eden-miz/R6P4/Rapport seances/Mizrahi_Rapport scéance 8.docx

Rapport scéance 8

A la dernière scéance j’avais essayé de souder les éléments à une plaque plus fine mais cela a créé des cours circuit.

A cette scéance nous avons donc du refaire le circuit initiale sur notre plaque blanche. Nous avons changé le nom du bluetooth , le programme de test du bluetooth c’est donc téléversé sans souci, la carte arduino nano n’est pas endommagé. Ensuite nous avons transferré le code final, cela a fonctionnait, nous avons pu faire tourner le moteur comme prévu.

Il fallait maintenant faire rentrer le dispositif dans la chaussure. En faisant cela , quelques filles ce sont débranchés. Nous avons donc tout ressorti , et tout rebranché mais la le programme le marchait plus, il ne voulait même plus téléverser. Pourtant nous arrivions tout de même à reconnaitre le module bluetooth et se connecter à lui. Nous avons passer tellement d’heure à essayer de comprendre. Chez moi j’ai tout défait et tout refait mais toujours rien .

Je joint les photos du montage.

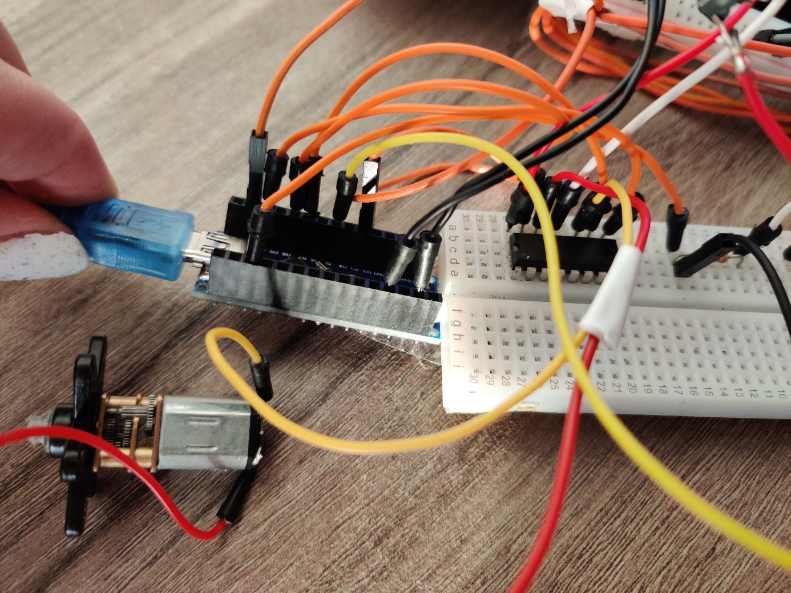
[picture p15: figure]
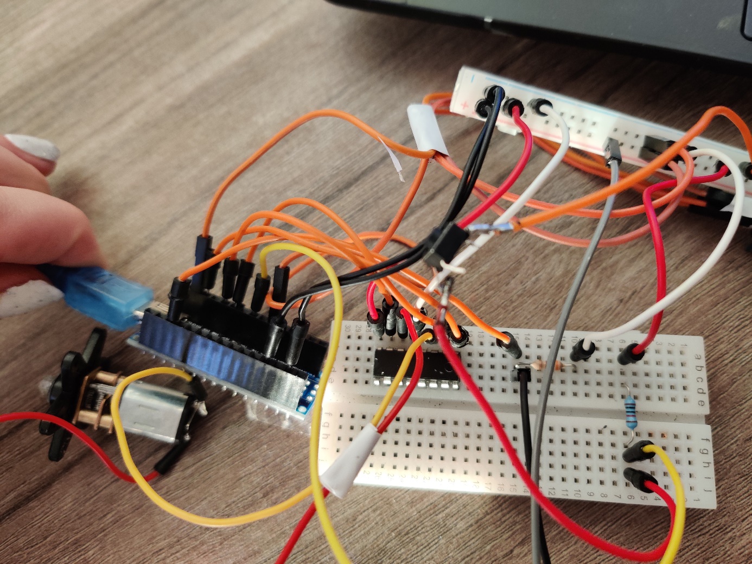
[picture p16: figure]
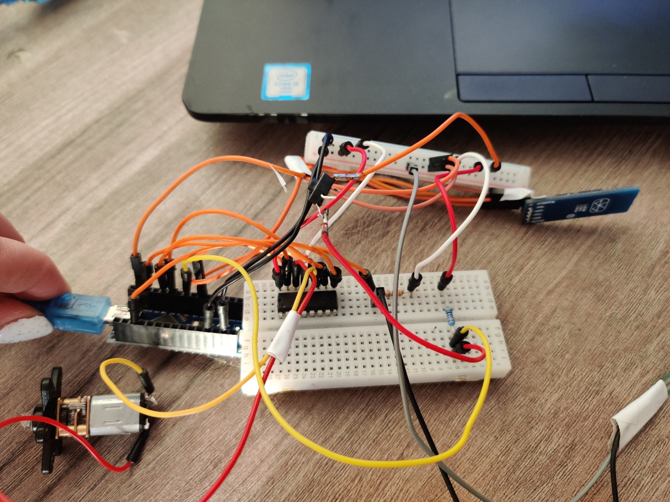
[picture p17: figure]
