eden-miz/R6P4/Rapport seances/ALOUANE rapport seance 3.pdf

Alouane Houda G3

Rapport Séance 4

Cette semaine, nous avons décidé de faire quelques modifications.

Nous avons décidé d’utiliser un moteur à courant continu au lieu d’un servo- moteur car nous avons besoin d’une rotation de plus de 180 degrés pour bien serrer les lacets. De plus le servo -moteur occupe beaucoup plus d’espace qu’un petit moteur cc.

A la place d’un boitier composé de 4 piles, nous allons mettre une batterie de 3.7 V munie d’un chargeur et d’un port USB qui sera apparent. Ainsi l’utilisateur pourra recharger la batterie.

Au niveau du code, j’ai écrit un code permettant de tester le capteur de force.

J’ai ensuite fait des recherches sur le moteur cc. J’ai fini par écrire un code pour tester la rotation du moteur dans un sens (pour les lacets) puis dans l’autre (pour le scratch).

Nous avons eu des difficultés à faire marcher le moteur. Le problème semblait venir de la puce.

J’ai proposé de rajouter une fonctionnalité (par exemple un compteur de pas / tally counter). Mais cela va dépendre de notre avancement et de l’espace qu’il nous restera.

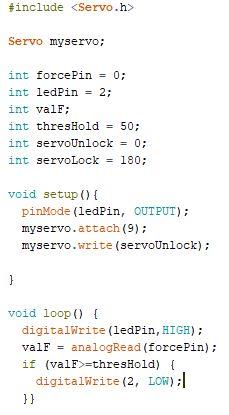
[picture p22: figure]
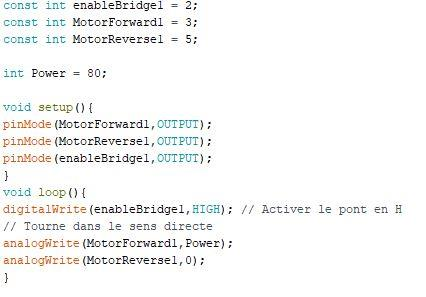
[picture p23: figure]
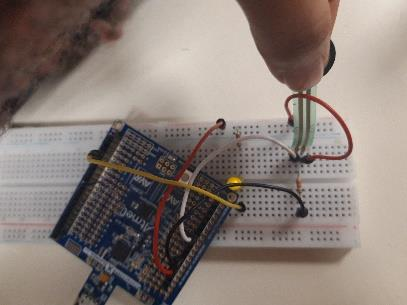
[picture p24: figure]
