eden-miz/R6P4/Rapport seances/Mizrahi_Rapport5.docx

Mizrahi-Rapport scéance 6

Aujourd’hui j’ai essayé de coder l’algorithme que j’avais conceptué à la derniere scéance en utilisant le bluetooth. Cela à donné ca :

if (BlueT.available()){

Data=BlueT.read();

if (Data=='1') {

Serial.println("Avancer");

avancer();

delay(3000);

stopMvt();

}

if (Data=='2') {

Serial.println("Avancer");

avancer();

delay(5000);

stopMvt();

}

}

Problème c’est que je n’arrivais pas à faire la connexion avec mon ordi . Quand j’écrivais AT rien ne s’envoyai. Vous m’avez fait remarquer que le problème venait du branchement rx tx. Ensuite nous avons pu nous connecter au bluetooth mais le programme général ne répondait toujours pas. Impossible de le téléverser.

Cette séance n’a donc pas était très productive car nous avons eu énormément de problème de téléversement.

Le programme entier a été mis sur guithub sous le nom de séance5.
