eden-miz/R6P4/Rapport seances/ALOUANE rapport seance 5.pdf

ALOUANE Houda G3

Rapport séance 5

Le but de cette séance était essentiellement de faire fonctionner le Bluetooth.

Nous avons commencé par tout relier : moteur cc, bouton, module Bluetooth. Ensuite nous avons rassemblé dans un seul fichier les codes permettant de faire fonctionner chaque composant.

Quant au moteur, nous avons redéfini de nouvelles fonctions pour le faire tourner dans 2 sens ou de le freiner, de 2 façons différentes. Nous avons effectué un premier essai sans Bluetooth qui était réussi.

Cette séance n’a pas été productive. En effet, nous avons eu de gros problèmes de téléversement sur les deux ordinateurs. Par conséquence, nous n’avons pas pu tester nos codes ou éventuellement les corriger.

Nous allons alors essayer de résoudre ce problème avant la séance prochaine et de limer l’intérieur de la chaussure pour faire plus d’espace.

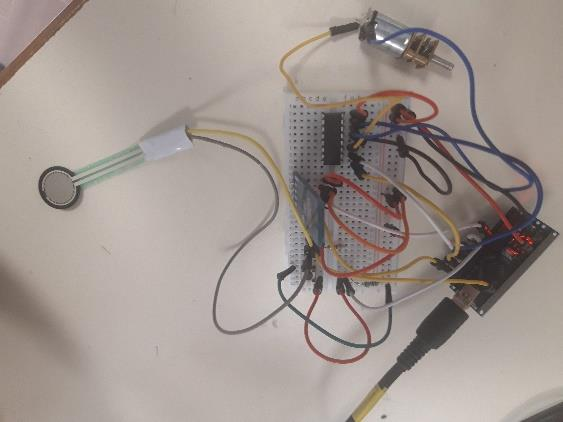
[picture p34: figure]
