eden-miz/R6P4/Rapport seances/ALOUANE rapport seance 4.pdf

ALOUANE Houda G3
Rapport séance 4

Aujourd’hui, nous nous sommes concentrées sur la résolution des problèmes rencontrés lors des séances précédentes.

La semaine dernière, nous n’avons pas pris en compte la taille de la plaque dont nous aurons besoin pour brancher le moteur au composant L293D et pour le composant Bluetooth. Nous avons alors décidé de la diviser en deux et de la coller contre la semelle.

Le composant Bluetooth nous oblige donc a placer la batterie a l’extérieur. Nous allons essayer de modéliser et d’imprimer un boîtier en 3D, ressemblant a celui de Nike pour la camoufler.

Après avoir rajouté le code permettant de desserrer les chaussures sur l’application, je me suis rendue compte de l’impraticabilité que cela pose a l’utilisateur. L’idée est donc d’utiliser le Bluetooth pour personnaliser le niveau de serrage. L’utilisateur aura le choix entre 4 boutons. Le bouton X permet de serrer et donc de faire tourner le moteur pendant X secondes, etc..

Afin de résoudre le problème du moteur, j’ai fait des recherches sur le composant L293D puis j’ai écris une nouvelle fonction. Finalement j’ai réussi a le faire tourner dans les deux sens. Afin de déterminer la source de l’erreur, je l’ai testé avec 3 cartes. Le problème provient de la mini-carte. Nous allons donc en commander une autre, puisque l’espace est limité.

Chez moi, j’ai aussi rajouté une fonction de freinage puisqu’il s’agit d’un moteur qui tourne en continu.

Le but de la séance prochaine sera de rassembler toutes les fonctions dans un seul programme, de tester le système avant de commencer l’assemblage.

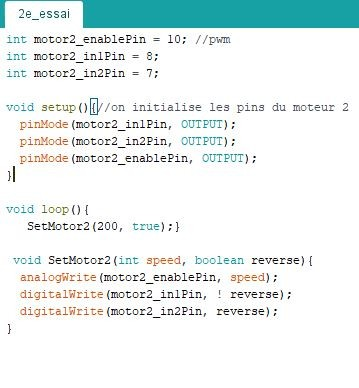
[picture p35: figure]
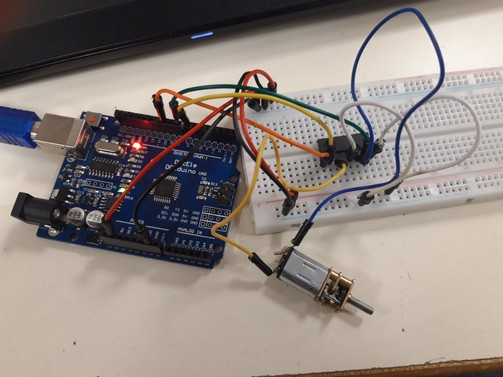
[picture p36: figure]
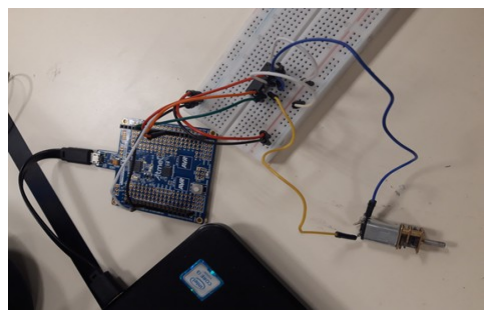
[picture p37: figure]
