eden-miz/R6P4/Rapport seances/ALOUANE rapport Seance 1.pdf

ALOUANE Houda G3

SMART SHOES

Rapport : Semaine 1

Lors de cette première séance, nous avons commencé par choisir le modèle de nos chaussures auto-laçantes sur Aliexpress. Nous avons alors considéré les aspects esthétiques et pratiques.

En effet, nous avons opté pour une chaussure bleue/verte, assortie a la carte Arduino et au moteur sheild. Nous avons également choisi une basket haute avec une semelle épaisse pour pouvoir
attahe les sevooteus et la atteie à l’aie ou à l’itieu de la haussure.

Idéalement, nous aimerions créer une chaussure auto-laçante compensée pou vite d’avoi u

## oitie à l’aie de la haussue. Mais ei isue d’te diffiile à alise, puisu’il faut pede e

compte plusieurs facteurs ; la largeur de la chaussure, le ofot, la taille des oposats, et… Eden a alors fait un patron de la basket à talon.

Quant à moi, je me suis occupée de la partie code. D’aod, ous avos

## essayé de faire un organigramme. Esuite j’ai otiu à faie des eheches

pour comprendre comment interviennent les servomoteurs avec les

## capteurs de force, puisque nous ’avos u’ue seule soue su iteet

pou e pojet, ui ’est pas assez détaillée.

## J’ai do popos d’utilise deu sevooteus touats das 2 sens

opposés. Le 1er pour serrer le scratch se trouvant en haut de la chaussure, et le 2eme pour serrer le reste des lacets.

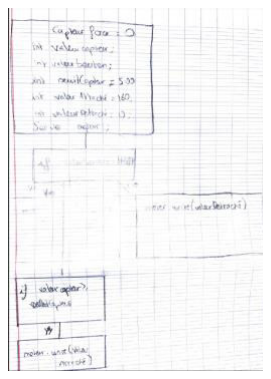
[picture p42: figure]

## Une fois les lacets serrés gâe au apteus, ous auos esoi de les dessee. C’est là

u’iteviet le outo poussoi. J’ai donc essayé de modifier et de réutiliser le programme du

## outo ue ous avos fait au dut de l’ae. Ce ui ’a pas fonctionné. Nous avons également

eu des problèmes de televersement dont la résolution a consommé beaucoup de temps.

## J’ai donc fait un otage d’u seul sevooteu, d’un bouton poussoir et j’ai essa d’ie u

programme qui permet au servomoteur de ne pas revenir à sa position initiale une fois le bouton lâché.

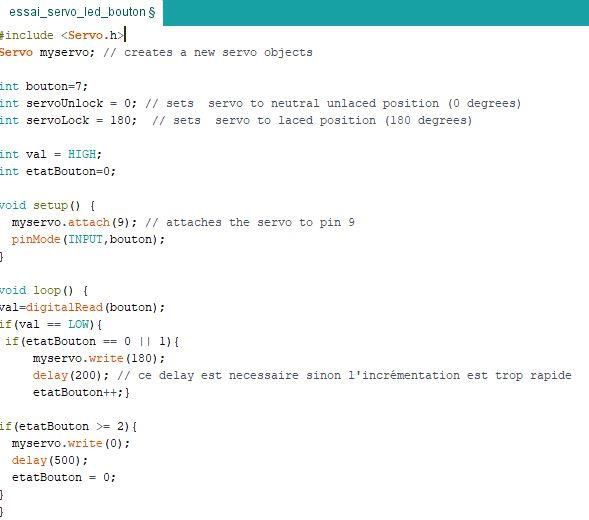
[picture p43: figure]
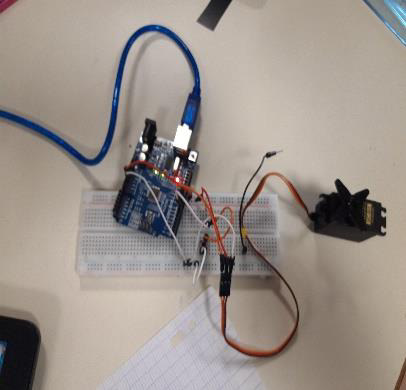
[picture p44: figure]
